Dylan0623/Infrared_temperature_measurement/README.md

# Infrared_temperature_measurement
2020年湖北省电赛省赛
