Dylan0623/Infrared_temperature_measurement/Src/main.c

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
/* Includes ------------------------------------------------------------------*/
#include "main.h"
#include "i2c.h"
#include "tim.h"
#include "usart.h"
#include "gpio.h"

/* USER CODE BEGIN Includes */
#include "mlx90614.h"
#include "stdio.h"
#include "motor.h"
#include "uart_handler.h"
#include "control.h"
#include "linefinder.h"
#include "BPSim.h"

/* USER CODE END Includes */

/* USER CODE BEGIN PD */
int ID;
uint8_t len;	
int mode;
int times=0,recive_flag,mask,face,learn;
float Temperature,Temperature_Skin;
uint8_t Temperature_limit ;
char mask_flag[5],face_flag[5];
float skin_temp;
uint8_t	UART1RxBuffer[1],UART2RxBuffer[1],UART3RxBuffer[1],UART4RxBuffer[1];
char Uart_get[20];
uint16_t Distance;
float BP_in[2],BP_out[1];
unsigned char ucRxData[100];
unsigned char ucRxFinish=0;
static unsigned char ucCnt=0;
char screen_get[10];
unsigned char ucRxcnt = 0;
uint8_t value = 0;
char get_val[8],get_id[8],get_mode[8];
/* USER CODE END PD */


void SystemClock_Config(void);
/**
  * @brief  The application entry point.
  * @retval int
  */
int main(void)
{
  /* MCU Configuration--------------------------------------------------------*/

  /* Reset of all peripherals, Initializes the Flash interface and the Systick. */
  HAL_Init();

  /* Configure the system clock */
  SystemClock_Config();

  /* Initialize all configured peripherals */
  MX_GPIO_Init();
  MX_TIM1_Init();
  MX_USART1_UART_Init();
  MX_I2C1_Init();
  MX_TIM2_Init();
  MX_I2C2_Init();
  MX_TIM5_Init();
  MX_USART2_UART_Init();
  MX_USART3_UART_Init();
  MX_UART4_Init();
  /* USER CODE BEGIN 2 */
	HAL_UART_Receive_IT(&huart1,UART1RxBuffer,1);
	HAL_UART_Receive_IT(&huart2,UART2RxBuffer,1);
	HAL_UART_Receive_IT(&huart3,UART3RxBuffer,1);
	HAL_UART_Receive_IT(&huart4,UART4RxBuffer,1);
	HAL_TIM_Base_Start_IT(&htim5);	//开启定时器5，定时0.1s，均值滤波
	simInit();
	MLX90614_Init(&hi2c1);
  MLX90614_SetEmissivity(0.985); // Human skin
  /* USER CODE END 2 */

  /* Infinite loop */
  /* USER CODE BEGIN WHILE */
  while (1)
  {
//		uartx_printf(huart1,"%d",mode);
//		Beep();
		if(mode == 1)
		{
			Control_Loop_A();
		}
		else if(mode == 2)
		{
			Control_Loop_B();
		}
		else if(mode == 3)
		{
			Control_Loop_C();
			HAL_Delay(50);
		}
		else if(mode == 4)
		{
			Control_Loop_D();
			HAL_Delay(50);
		}
    /* USER CODE END WHILE */

    /* USER CODE BEGIN 3 */
  }
  /* USER CODE END 3 */
}

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
/* USER CODE BEGIN 4 */
void HAL_UART_RxCpltCallback(UART_HandleTypeDef *huart)
{
	unsigned char temp=0;
	extern unsigned char UART1RxBuffer[1];
	
	__HAL_UART_CLEAR_PEFLAG(huart);
	
	if(huart->Instance == USART1)			//串口1接收中断处理
	{
		Camera_Get(UART1RxBuffer);
	}
	if(huart->Instance == USART2)			//串口2接收中断处理
	{
		temp = UART2RxBuffer[0];
		ucRxData[ucCnt++]=temp;
		if(temp=='m') 
			{ 
				ucRxFinish=1;
			  ucCnt=0;
			}
	}
	if(huart->Instance == USART3)			//串口3接收中断处理
	{
		Screen_get(UART3RxBuffer);
	}
	if(huart->Instance == UART4)			//串口4接收中断处理
	{
		Camera_Get(UART4RxBuffer);
	}
	HAL_UART_Receive_IT(&huart1,UART1RxBuffer,1);
	HAL_UART_Receive_IT(&huart2,UART2RxBuffer,1);
	HAL_UART_Receive_IT(&huart3,UART3RxBuffer,1);
	HAL_UART_Receive_IT(&huart4,UART4RxBuffer,1);
}

void HAL_GPIO_EXTI_Callback(uint16_t GPIO_Pin)//外部中断，每检测到一次输入信号的上升沿，计数值frequency自增
{
	
}

void HAL_TIM_PeriodElapsedCallback(TIM_HandleTypeDef *htim) //均值滤波算法，算脉冲更精准
{
	if(htim-> Instance == htim5.Instance) 
	{
		
	}
}
/* USER CODE END 4 */
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
