Dylan0623/Infrared_temperature_measurement/Servo-F407.ioc

Mcu.UserName=STM32F407VETx
PA10.Signal=USART1_RX
PA15.Signal=S_TIM2_CH1_ETR
PA9.Signal=USART1_TX
PB10.Signal=I2C2_SCL
PB11.Signal=I2C2_SDA
PB3.Signal=S_TIM2_CH2
PB8.Signal=I2C1_SCL
PB9.Signal=I2C1_SDA
PC10.Signal=UART4_TX
PC11.Signal=UART4_RX
PD5.Signal=USART2_TX
PD6.Signal=USART2_RX
PD8.Signal=USART3_TX
PD9.Signal=USART3_RX
PE11.Signal=S_TIM1_CH2
PE13.Signal=S_TIM1_CH3
PE14.Signal=S_TIM1_CH4
PE6.GPIO_Label=Beeper
PE6.Signal=GPIO_Output
PE7.GPIO_Label=Laser
PE7.Signal=GPIO_Output
PE9.Signal=S_TIM1_CH1
PH0-OSC_IN.Signal=RCC_OSC_IN
PH1-OSC_OUT.Signal=RCC_OSC_OUT
