Dylan0623/Infrared_temperature_measurement/Inc/main.h

#define Beeper_Pin GPIO_PIN_6
#define Beeper_GPIO_Port GPIOE
#define Laser_Pin GPIO_PIN_7
#define Laser_GPIO_Port GPIOE
#define debug_log 	printf
