Dylan0623/Infrared_temperature_measurement/Src/gpio.c

/**
  ******************************************************************************
  * File Name          : gpio.c
  * Description        : This file provides code for the configuration
  *                      of all used GPIO pins.
  ******************************************************************************
  * @attention
  *
  * <h2><center>&copy; Copyright (c) 2020 STMicroelectronics.
  * All rights reserved.</center></h2>
  *
  * This software component is licensed by ST under BSD 3-Clause license,
  * the "License"; You may not use this file except in compliance with the
  * License. You may obtain a copy of the License at:
  *                        opensource.org/licenses/BSD-3-Clause
  *
  ******************************************************************************
  */

/* Includes ------------------------------------------------------------------*/
#include "gpio.h"
/*----------------------------------------------------------------------------*/
/* Configure GPIO                                                             */
/*----------------------------------------------------------------------------*/
/** Configure pins as
        * Analog
        * Input
        * Output
        * EVENT_OUT
        * EXTI
*/
void MX_GPIO_Init(void)
{

  GPIO_InitTypeDef GPIO_InitStruct = {0};

  /* GPIO Ports Clock Enable */
  __HAL_RCC_GPIOE_CLK_ENABLE();
  __HAL_RCC_GPIOH_CLK_ENABLE();
  __HAL_RCC_GPIOB_CLK_ENABLE();
  __HAL_RCC_GPIOD_CLK_ENABLE();
  __HAL_RCC_GPIOA_CLK_ENABLE();
  __HAL_RCC_GPIOC_CLK_ENABLE();

  /*Configure GPIO pin Output Level */
  HAL_GPIO_WritePin(GPIOE, Beeper_Pin|Laser_Pin, GPIO_PIN_RESET);

  /*Configure GPIO pins : PEPin PEPin */
  GPIO_InitStruct.Pin = Beeper_Pin|Laser_Pin;
  GPIO_InitStruct.Mode = GPIO_MODE_OUTPUT_PP;
  GPIO_InitStruct.Pull = GPIO_NOPULL;
  GPIO_InitStruct.Speed = GPIO_SPEED_FREQ_LOW;
  HAL_GPIO_Init(GPIOE, &GPIO_InitStruct);

}

/* USER CODE BEGIN 2 */
void Laser_on(void)
{
	HAL_GPIO_WritePin(Laser_GPIO_Port,Laser_Pin,GPIO_PIN_SET);
}
void Laser_off(void)
{
	HAL_GPIO_WritePin(Laser_GPIO_Port,Laser_Pin,GPIO_PIN_RESET);
}
void Beep(void)
{
	HAL_GPIO_WritePin(Beeper_GPIO_Port,Beeper_Pin,GPIO_PIN_SET);
	HAL_Delay(200);
	HAL_GPIO_WritePin(Beeper_GPIO_Port,Beeper_Pin,GPIO_PIN_RESET);
	HAL_Delay(200);
	HAL_GPIO_WritePin(Beeper_GPIO_Port,Beeper_Pin,GPIO_PIN_SET);
	HAL_Delay(200);
	HAL_GPIO_WritePin(Beeper_GPIO_Port,Beeper_Pin,GPIO_PIN_RESET);
}
/* USER CODE END 2 */

/************************ (C) COPYRIGHT STMicroelectronics *****END OF FILE****/
